fossabot/hydra/archive/hydra_block_bkgnd.pdf

DAC

eFabless

Hydra

ADC | Vref | LDO

Iref

Temperature Sense | OpAmp | Input Buffer | PWM

Timer
