fossabot/hydra/doc/testboard.pdf

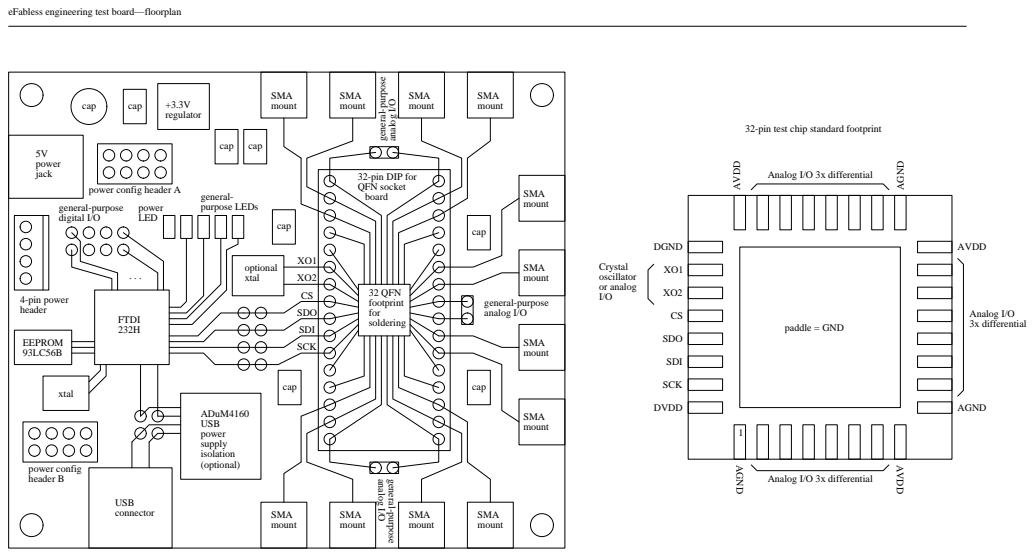
[picture p4: page 1]
USB connector; FTDI 232H; EEPROM 93LC56B; 32 QFN footprint for soldering; SMA mount; Analog I/O 3x differential; SCK; SDO; SDI; paddle = GND; AVDD; AGND; DGND; DVDD; Crystal oscillator or analog I/O; optional xtal; cap; xtal; general-; power; purpose LEDs; LED; general-purpose analog I/O; general-purpose; analog I/O; 5V power jack; +3.3V regulator; ADuM4160 USB power supply isolation; 4-pin power header

eFabless engineering test board—floorplan

32-pin test chip standard footprint

32-pin DIP for
QFN socket
board

power config header A
general-purpose
digital I/O

(optional) power config
header B

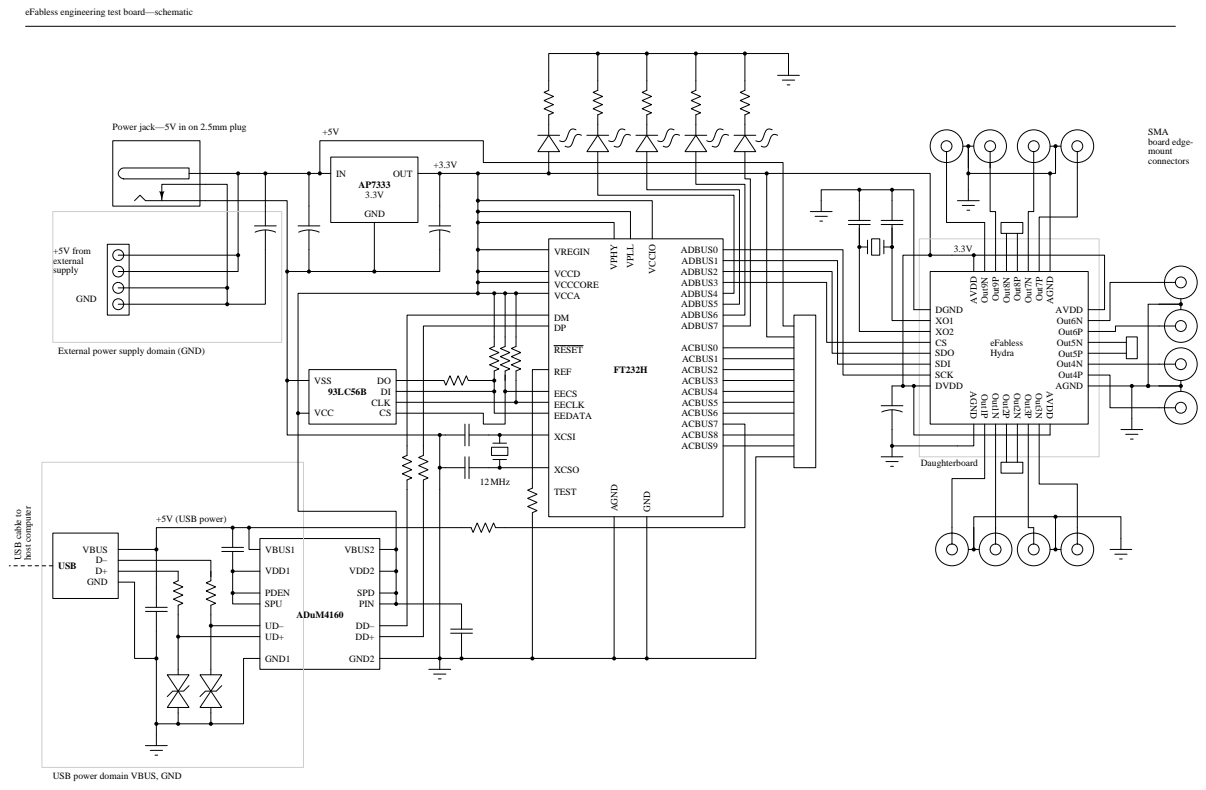
[picture p5: page 2]
VREGIN; VCCD VCCCORE VCCA; RESET; REF; EECS EECLK EEDATA; XCSI; XCSO; TEST; ADBUS0 ADBUS1 ADBUS2 ADBUS3 ADBUS4 ADBUS5 ADBUS6 ADBUS7; ACBUS0 ACBUS1 ACBUS2 ACBUS3 ACBUS4 ACBUS5 ACBUS6 ACBUS7 ACBUS8 ACBUS9; AGND; GND; VPHY; VPLL; VCCIO; VBUS1; VDD1; PDEN SPU; GND1; VBUS2; VDD2; SPD PIN; GND2; ADuM4160; OUT; CLK; VSS; VCC; AVDD; Out9N; Out9P; Out8N; Out8P; Out7N; Out7P; Out6N Out6P Out5N Out5P Out4N Out4P; Out1P; Out1N; Out2P; Out2N; Out3P; Out3N; SCK; SDO SDI; DGND; DVDD; eFabless Hydra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

eFabless engineering test board—schematic

Power jack—5V in on 2.5mm plug

External power supply domain (GND)

USB cable to

host computer +5V (USB power)

USB power domain VBUS, GND
