fossabot/hydra/doc/ENG_CD_292304_D2.pdf

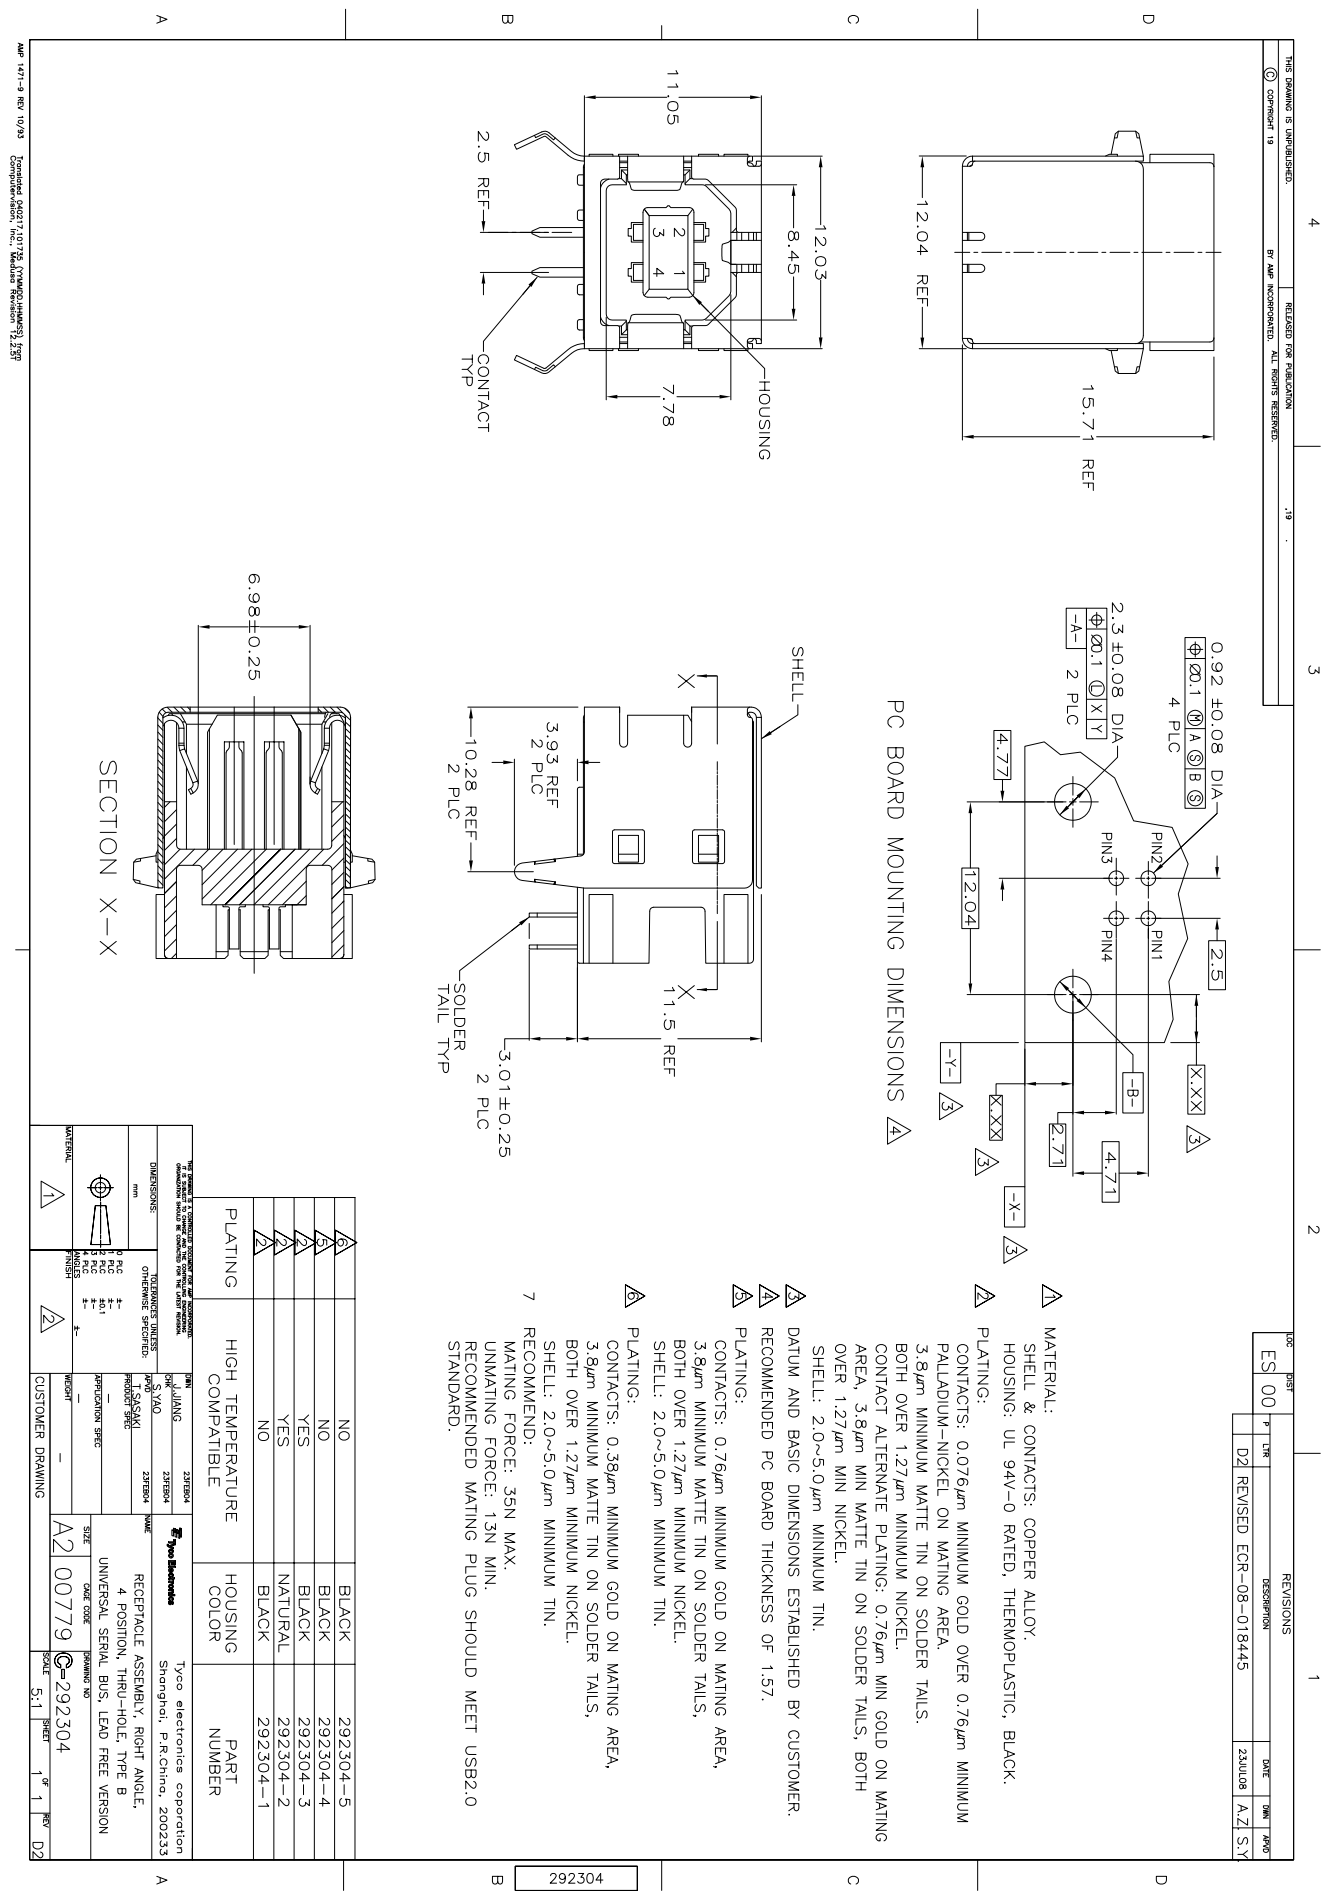
[picture p6: page 1]
