fossabot/hydra/doc/plastronics_32QFN_clamshell.pdf

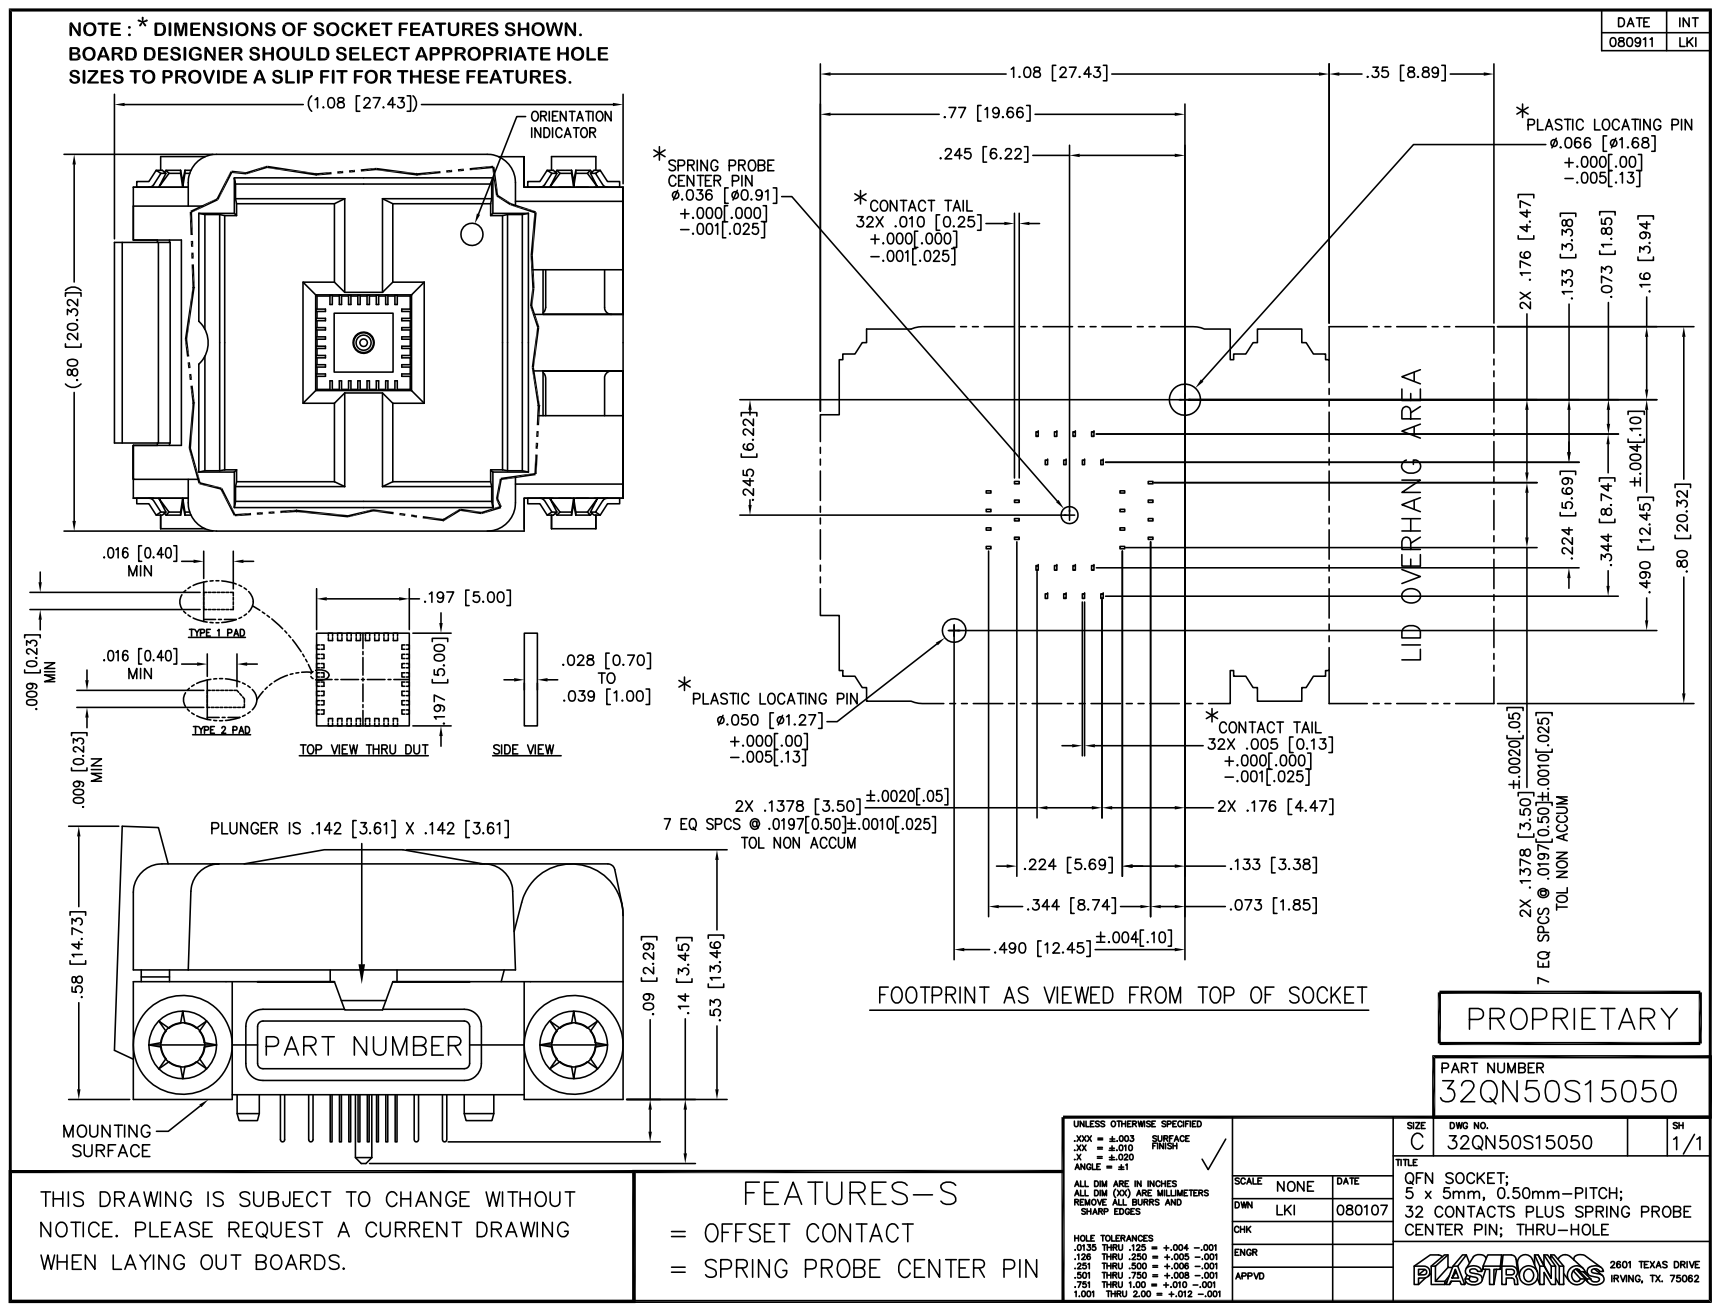
[picture p7: page 1]
