fossabot/hydra/pcb/hydra_testboard.png

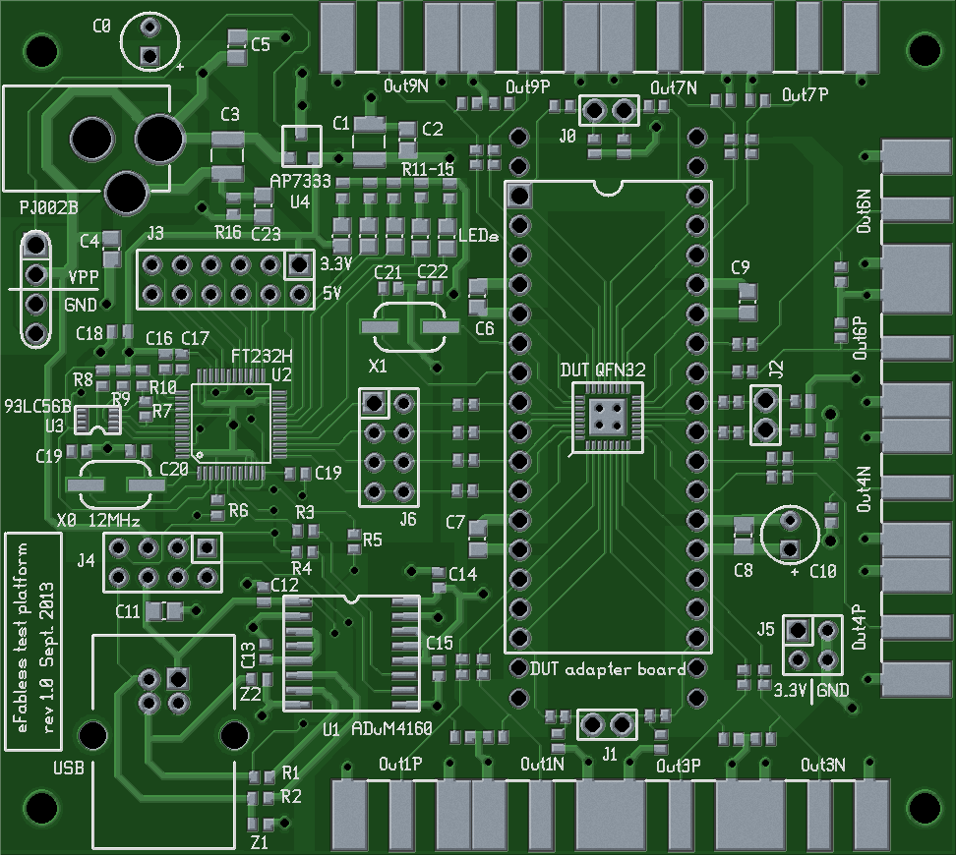
pcb/hydra_testboard.png
