fossabot/hydra/pcb/hydra_testboard_back.png

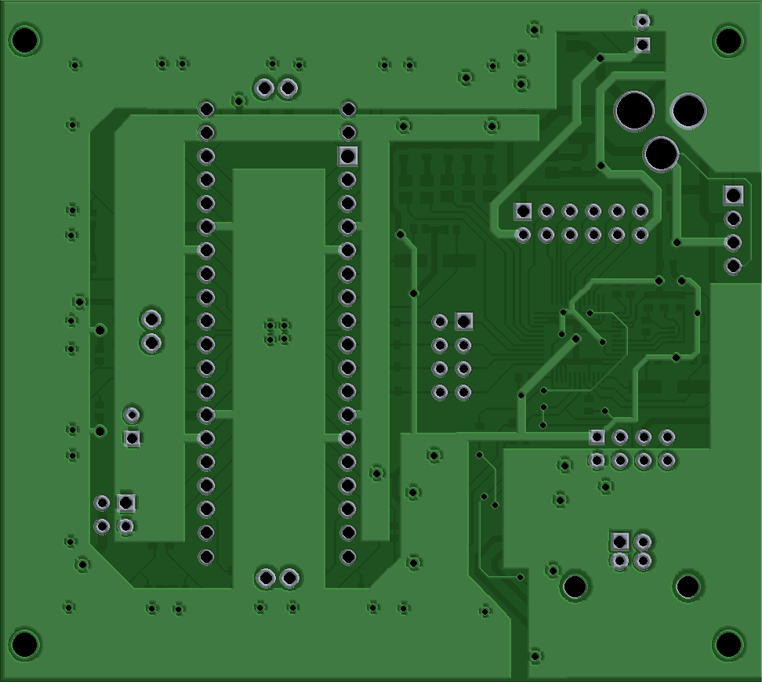
pcb/hydra_testboard_back.png
