fossabot/hydra/test/hydra_block_bkgnd.gif

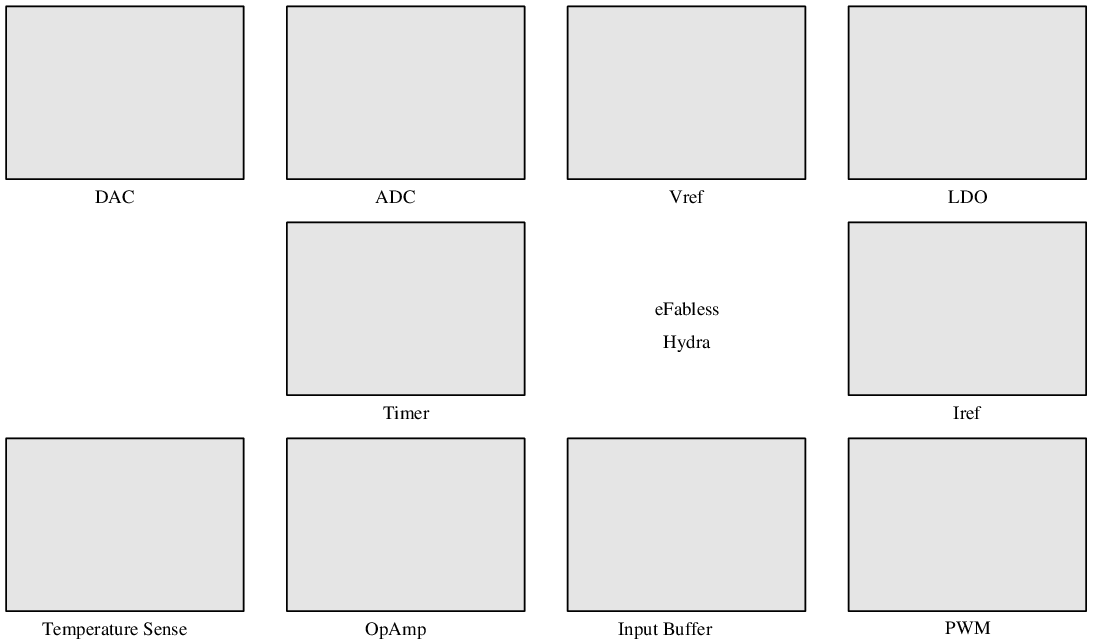
test/hydra_block_bkgnd.gif
